carpet852/Kello/photos/IMG_8491.JPG

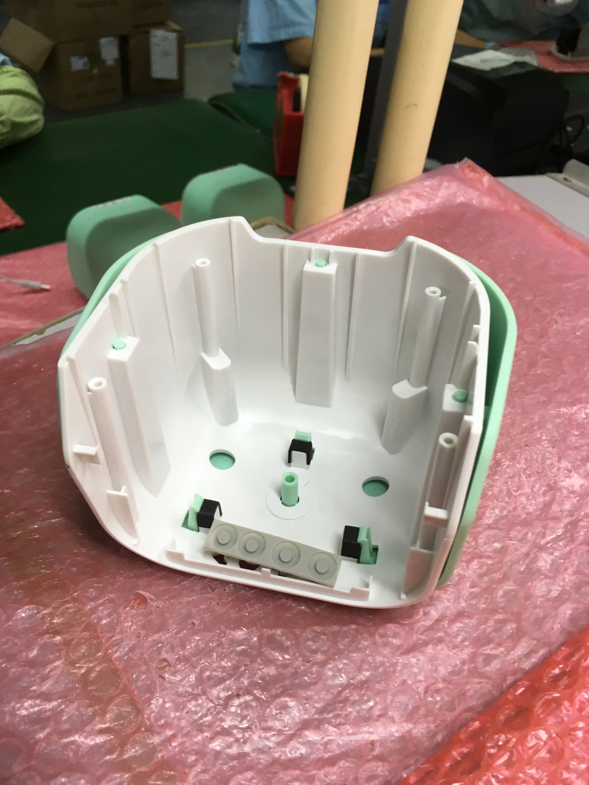
photos/IMG_8491.JPG
