carpet852/Kello/photos/IMG_8479.JPG

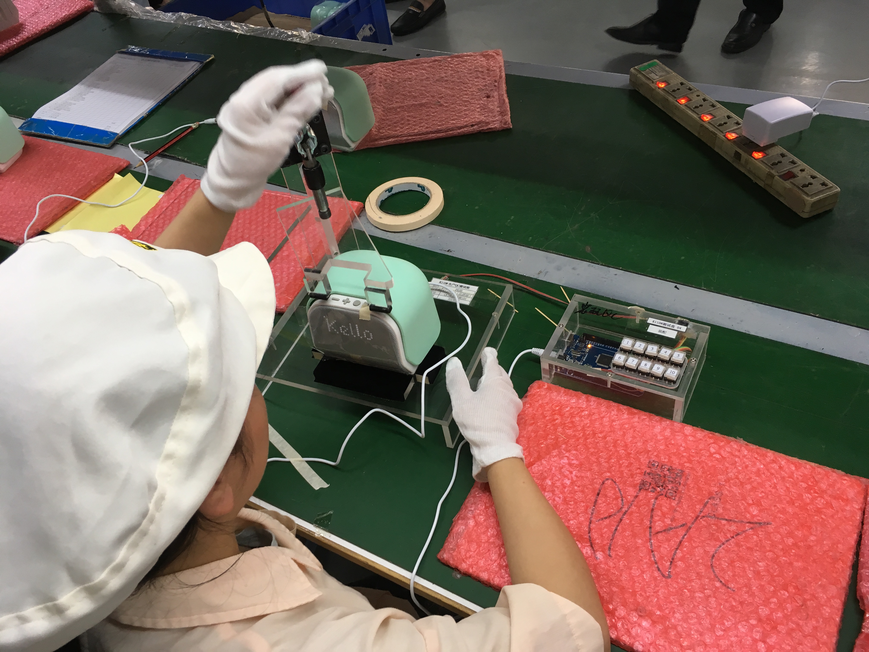
photos/IMG_8479.JPG
