carpet852/Kello/photos/13590448_10154298337113104_5472990157843542144_n.jpg

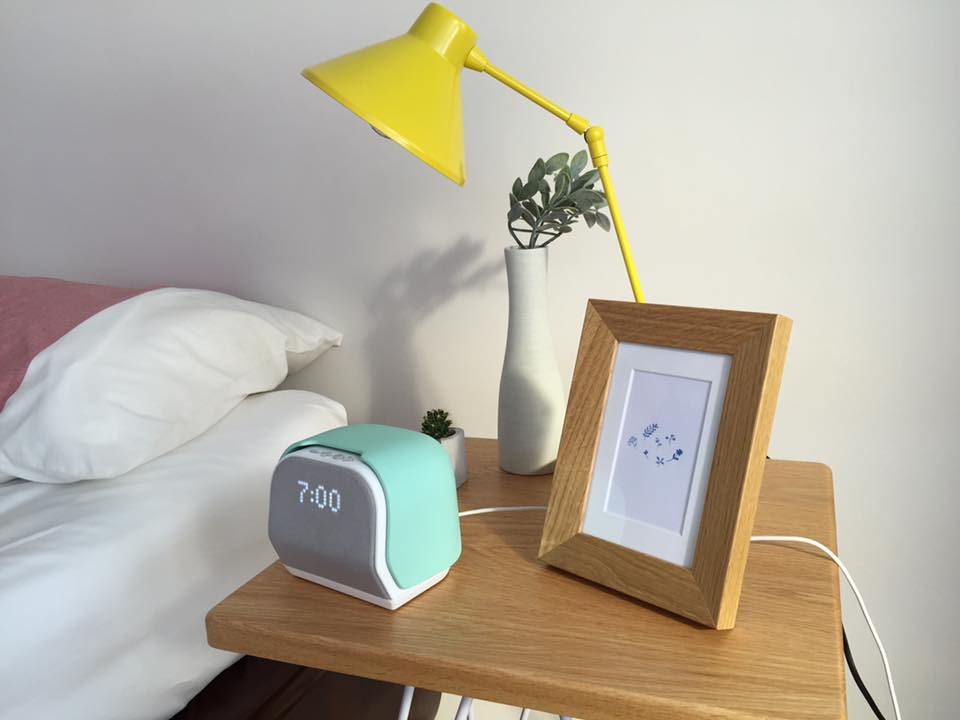
photos/13590448_10154298337113104_5472990157843542144_n.jpg
