carpet852/Kello/photos/CkaO5itWsAAXs07.jpg

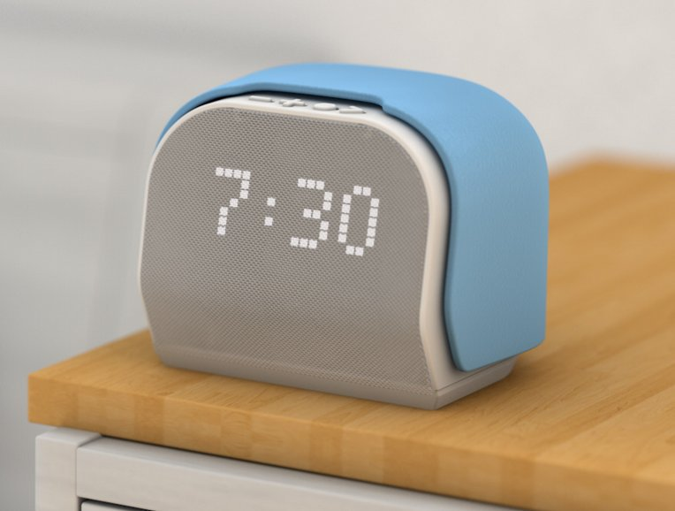
photos/CkaO5itWsAAXs07.jpg
