carpet852/Kello/photos/IMG_8485.JPG

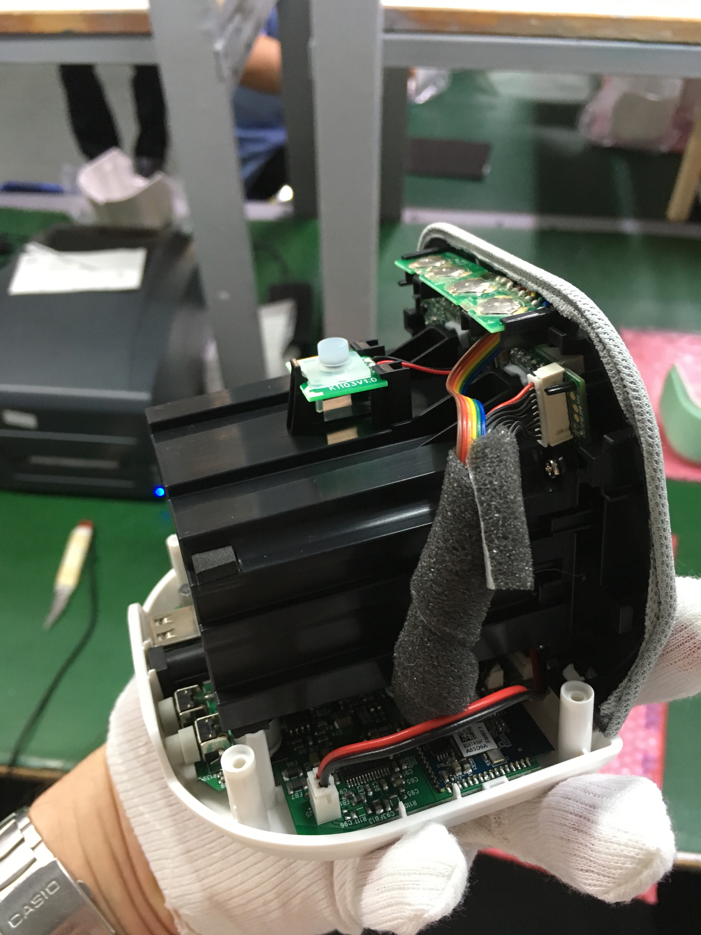
photos/IMG_8485.JPG
