carpet852/Kello/photos/IMG_8500.JPG

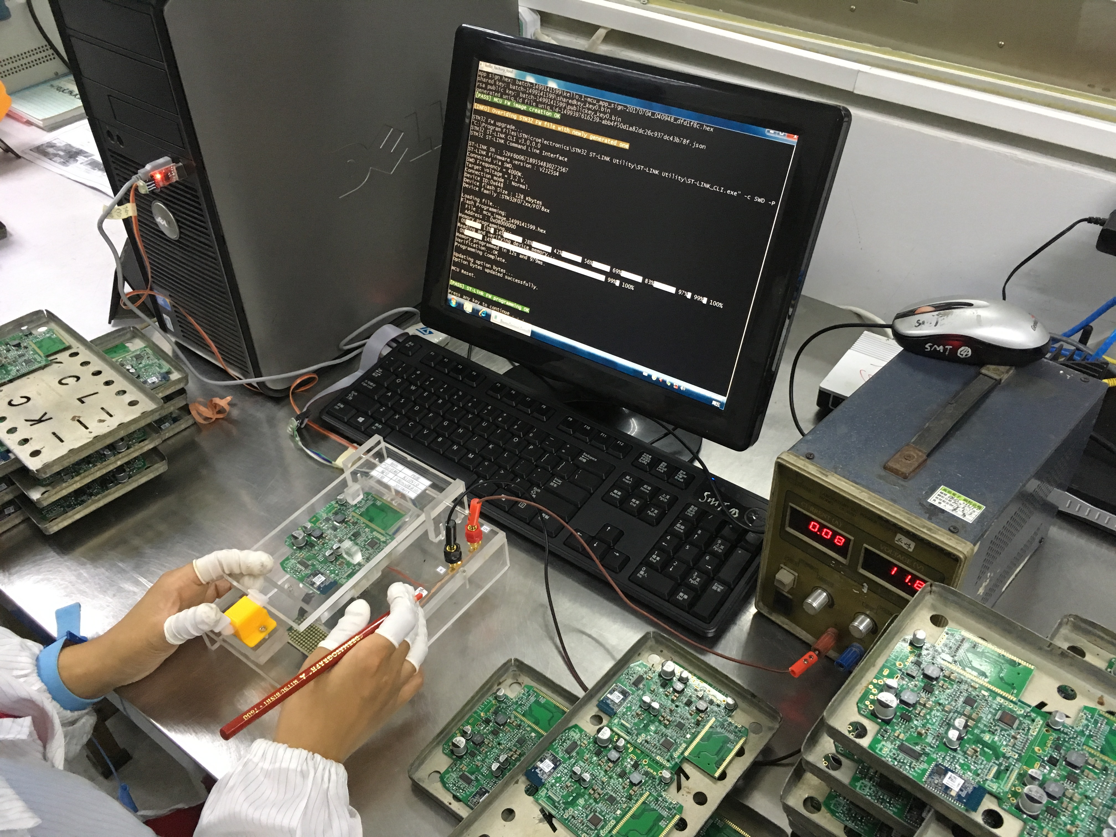
photos/IMG_8500.JPG
