carpet852/Kello/electronics/KELLO BUTTON V10 SCH.pdf

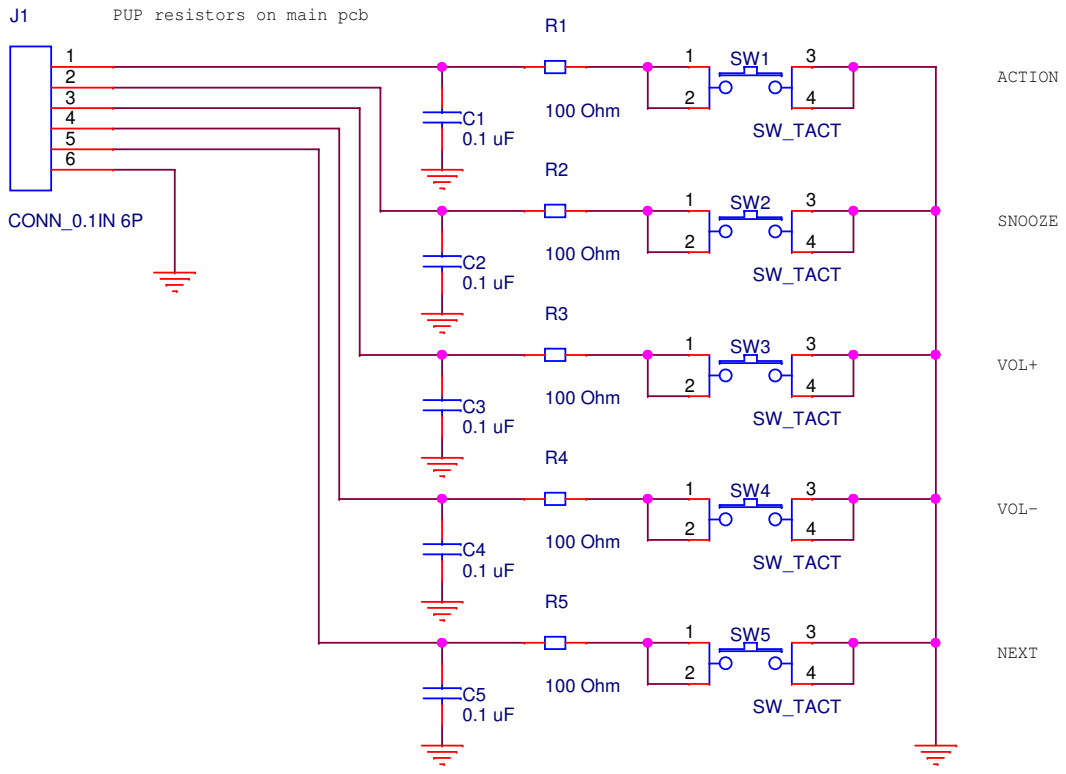
[picture p14: page 1]

PUP resistors on main pcb
