carpet852/Kello/electronics/KELLO_MAIN_V82_PROD_SCH.pdf

# KELLO block diagram

## WiFi

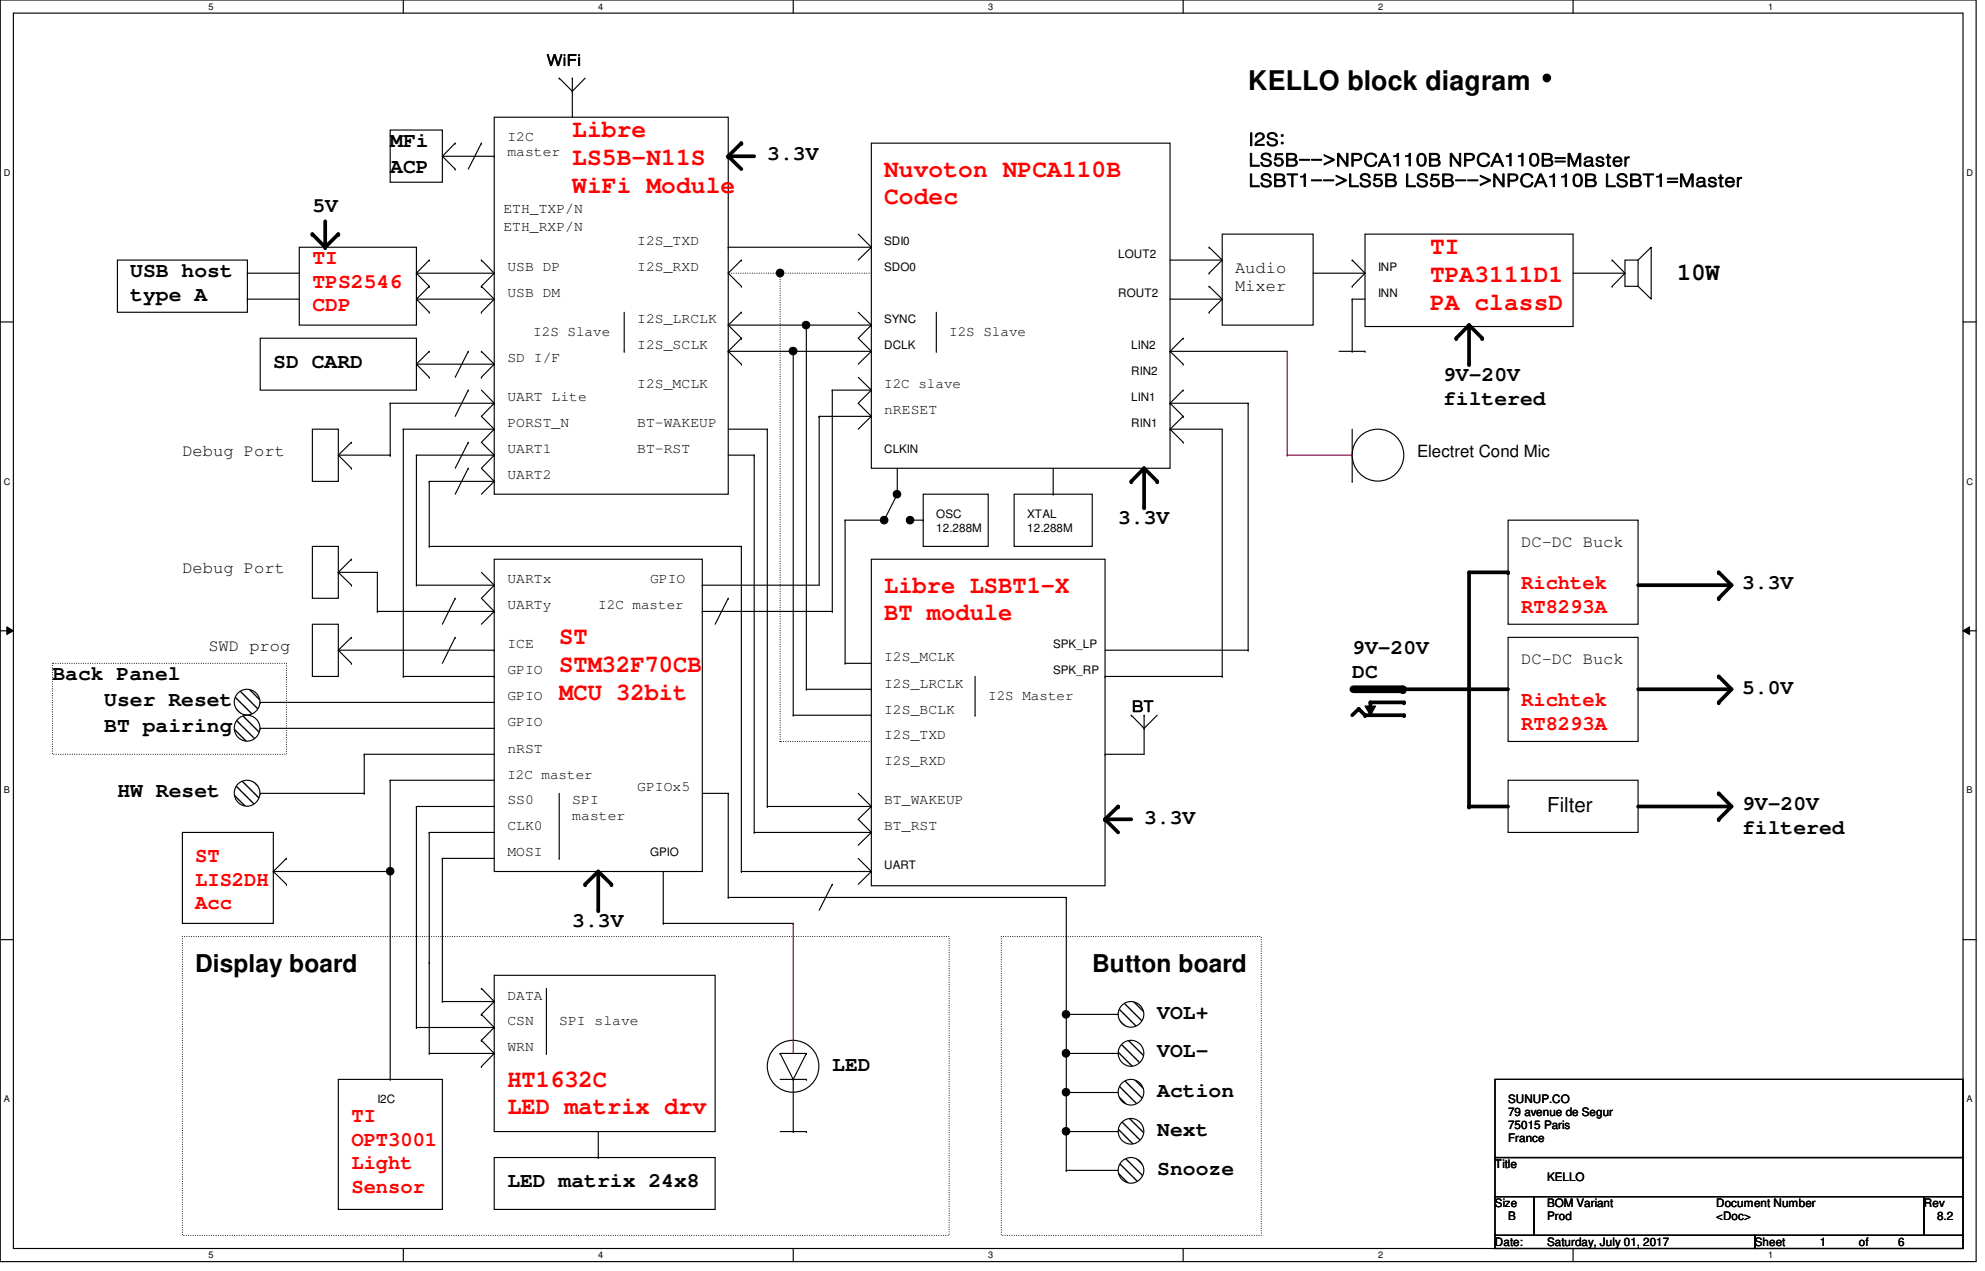
[picture p15: page 1]
I2S_RXD; UART Lite; ETH_TXP/N; SD CARD; Nuvoton NPCA110B Codec; I2S_LRCLK; USB DP; Debug Port; ETH_RXP/N; I2S_MCLK; Libre LS5B-N11S WiFi Module; USB DM; I2S_TXD; I2S_SCLK; ST STM32F70CB MCU 32bit; I2S: LS5B-->NPCA110B NPCA110B=Master LSBT1-->LS5B LS5B-->NPCA110B LSBT1=Master; UART2; USB host type A; VOL+; VOL-; Action; Next; I2C master; MFi ACP; Libre LSBT1-X BT module; I2S_BCLK; UART; DCLK; SDI0; SYNC; CLKIN; I2S Master; I2S Slave; BT-RST; BT-WAKEUP; BT_WAKEUP; BT_RST; I2C slave; UART1; UARTx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

Electret Cond Mic

DC-DC Buck

SUNUP.CO
79 avenue de Segur
75015 Paris
France

## Overvoltage 20.5V Reverse Pol. 1.3V

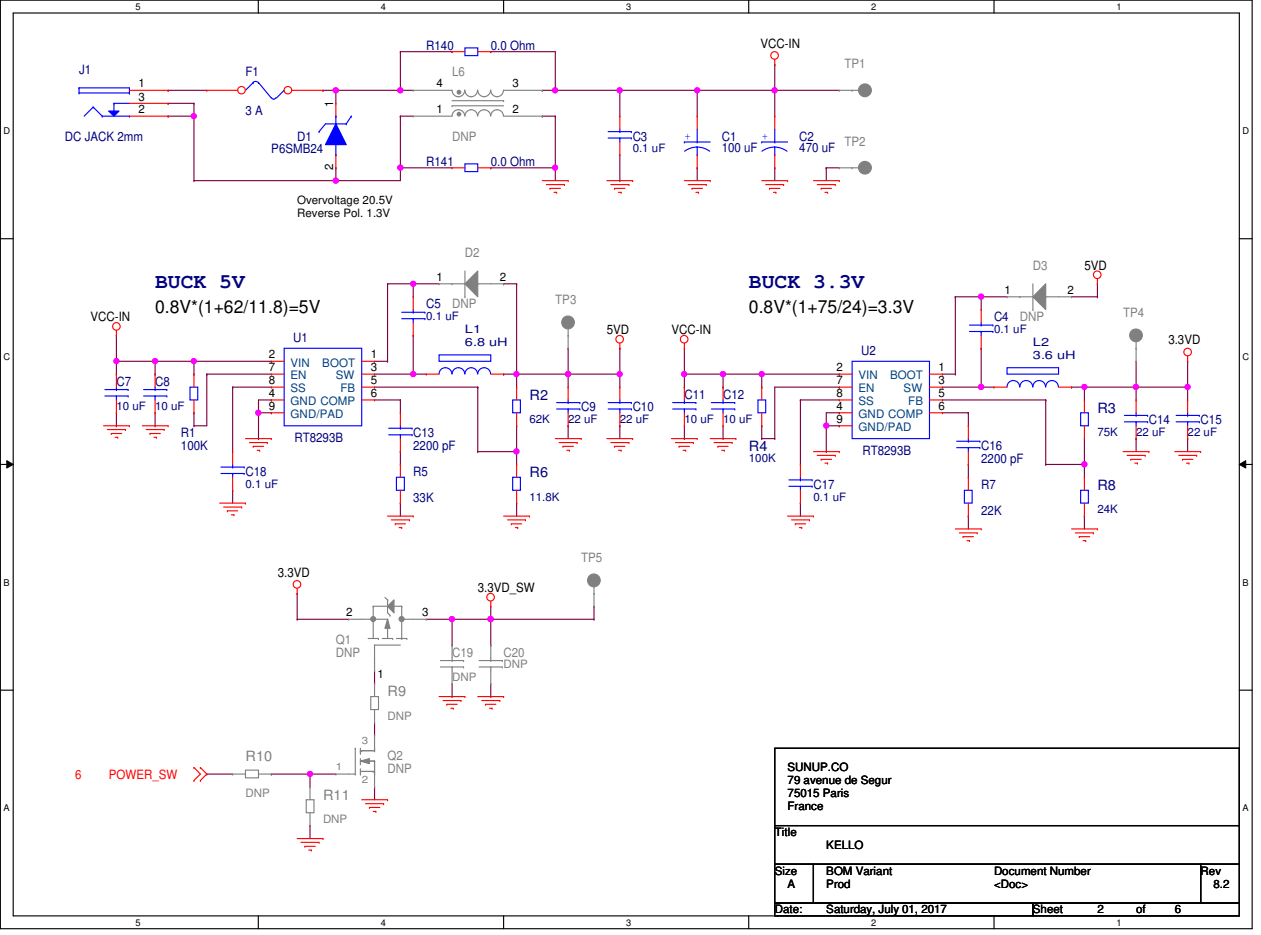
[picture p16: page 2]

## I2SDI_LSBT not supported in digital mode LSBT-A ADC method: unpop R14/R16/R18, pop R20

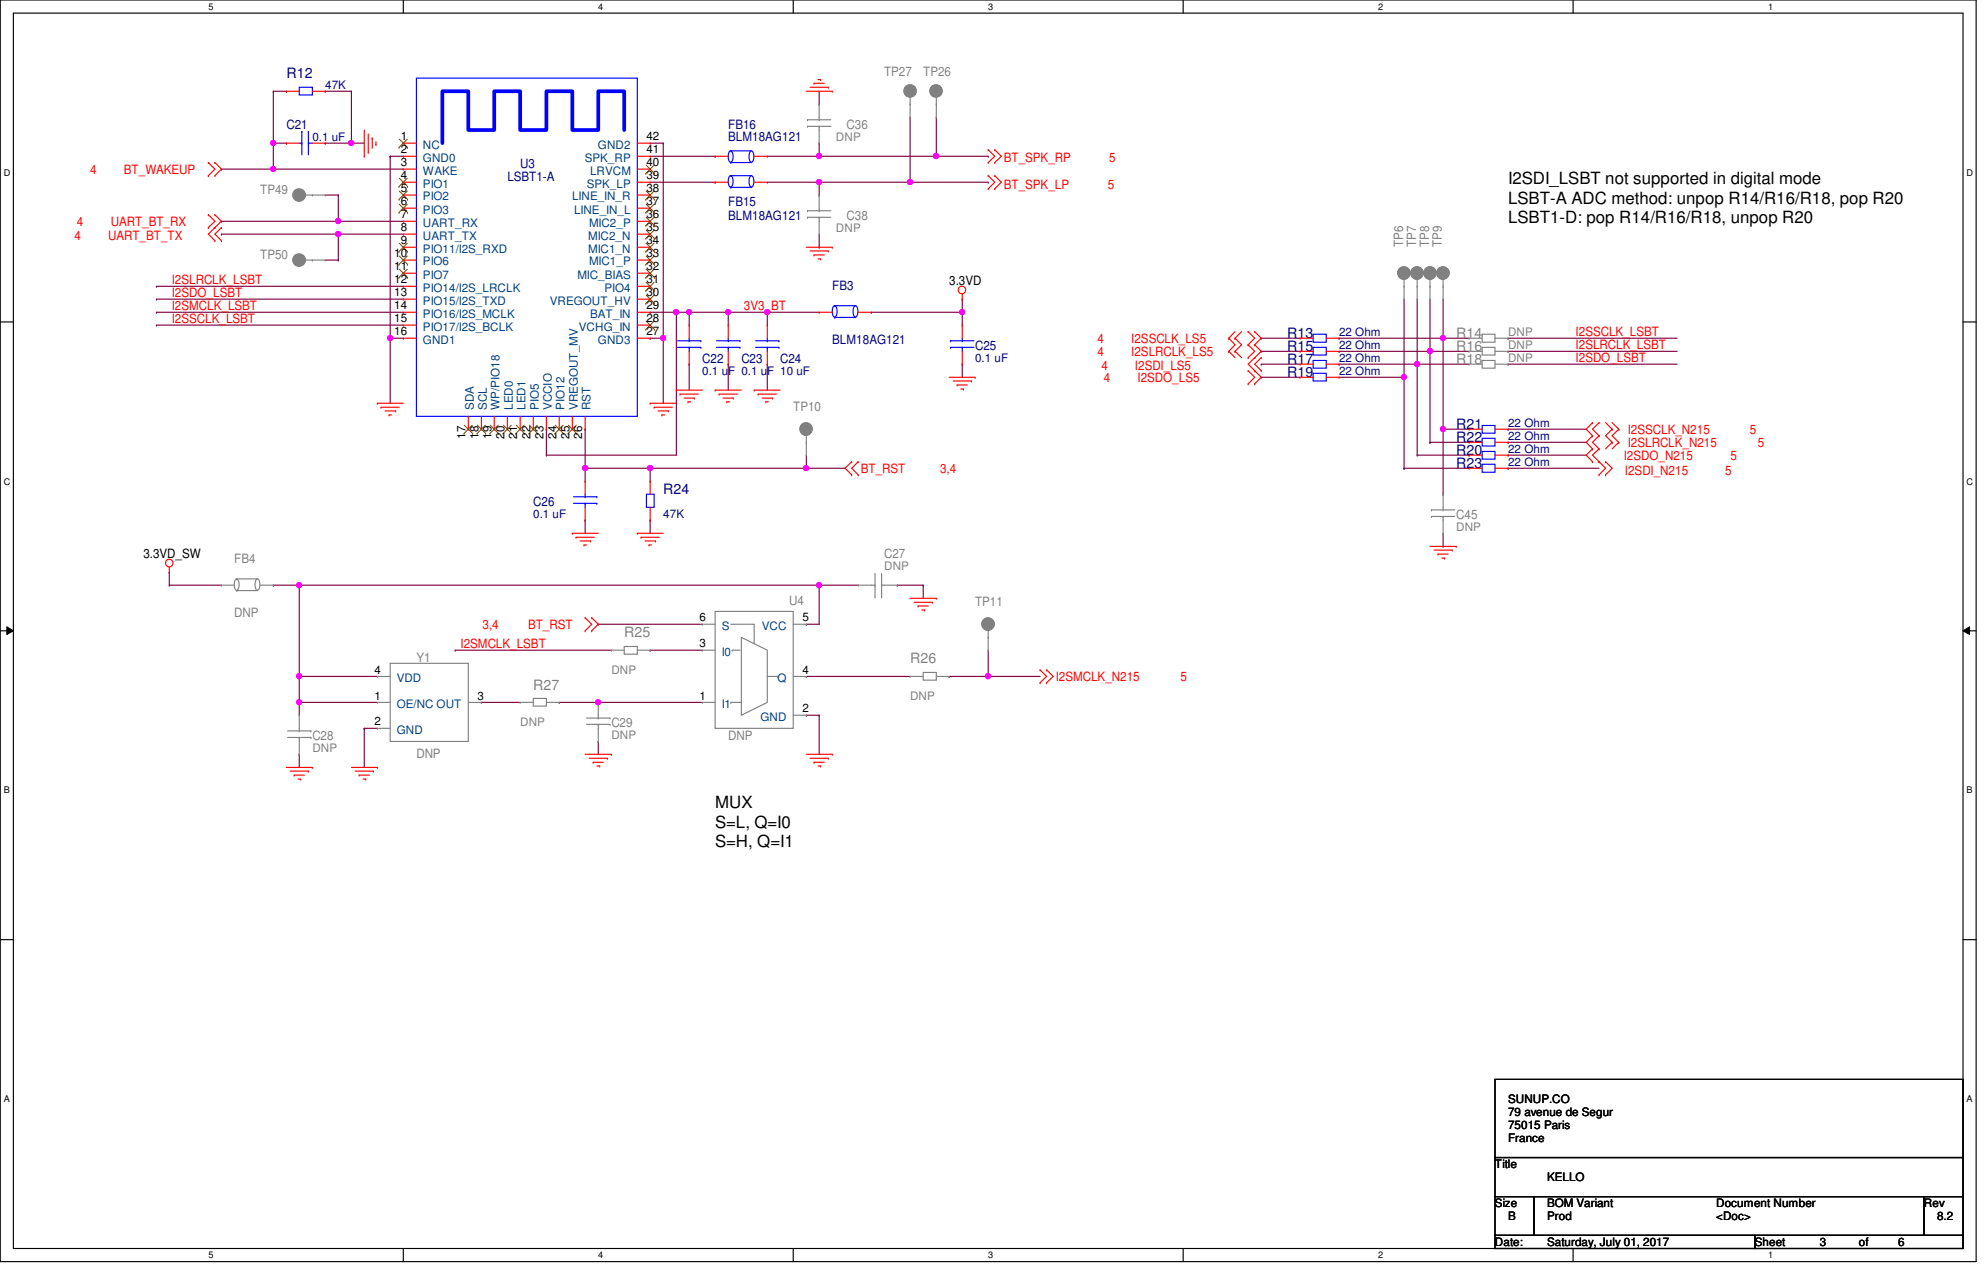
[picture p17: page 3]

## USB HOST

## cut PCB around LS5B antenna

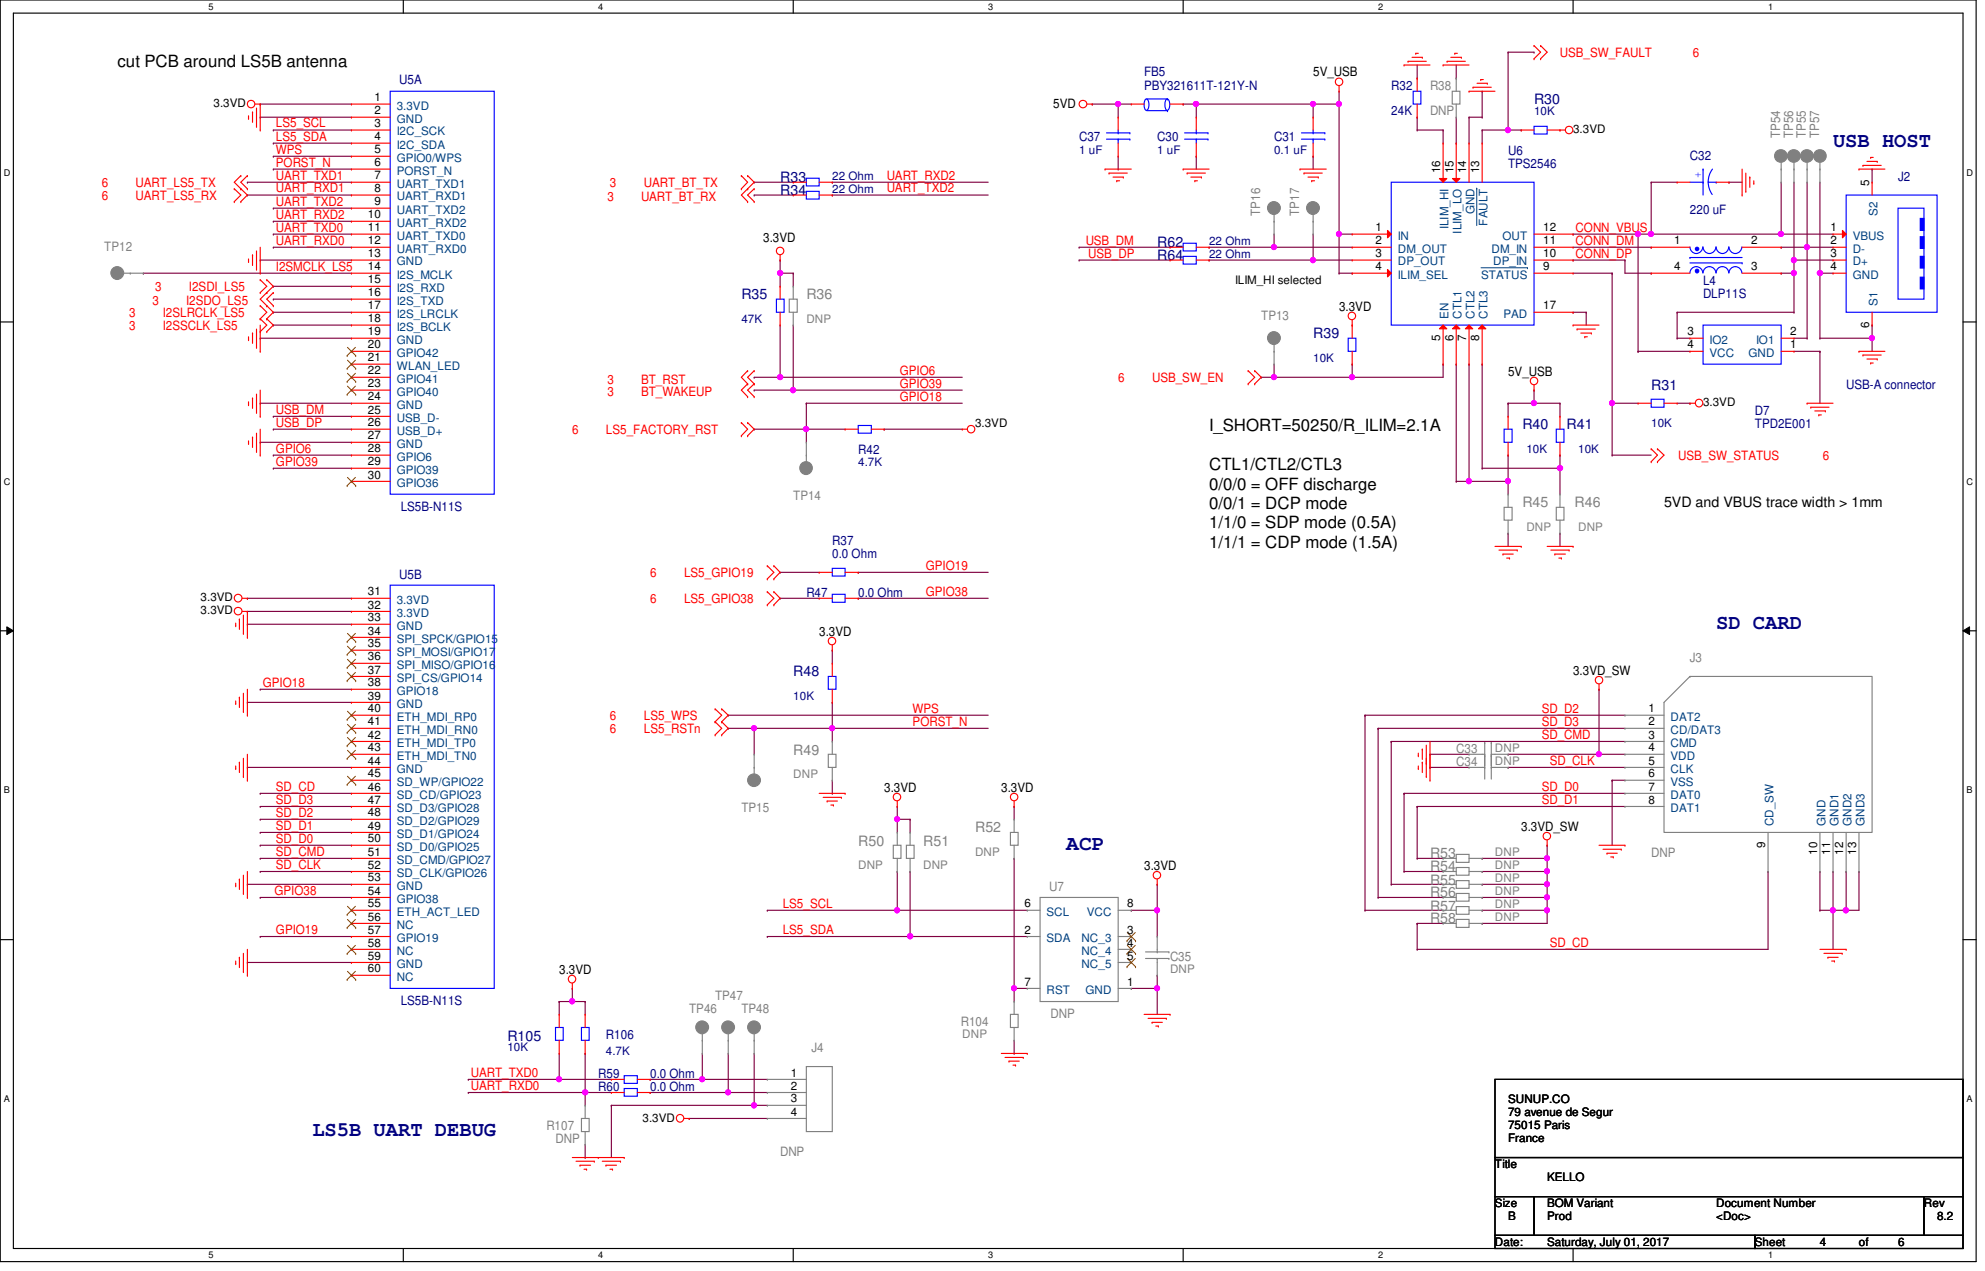
[picture p18: page 4]

5VD and VBUS trace width > 1mm

R68

R120

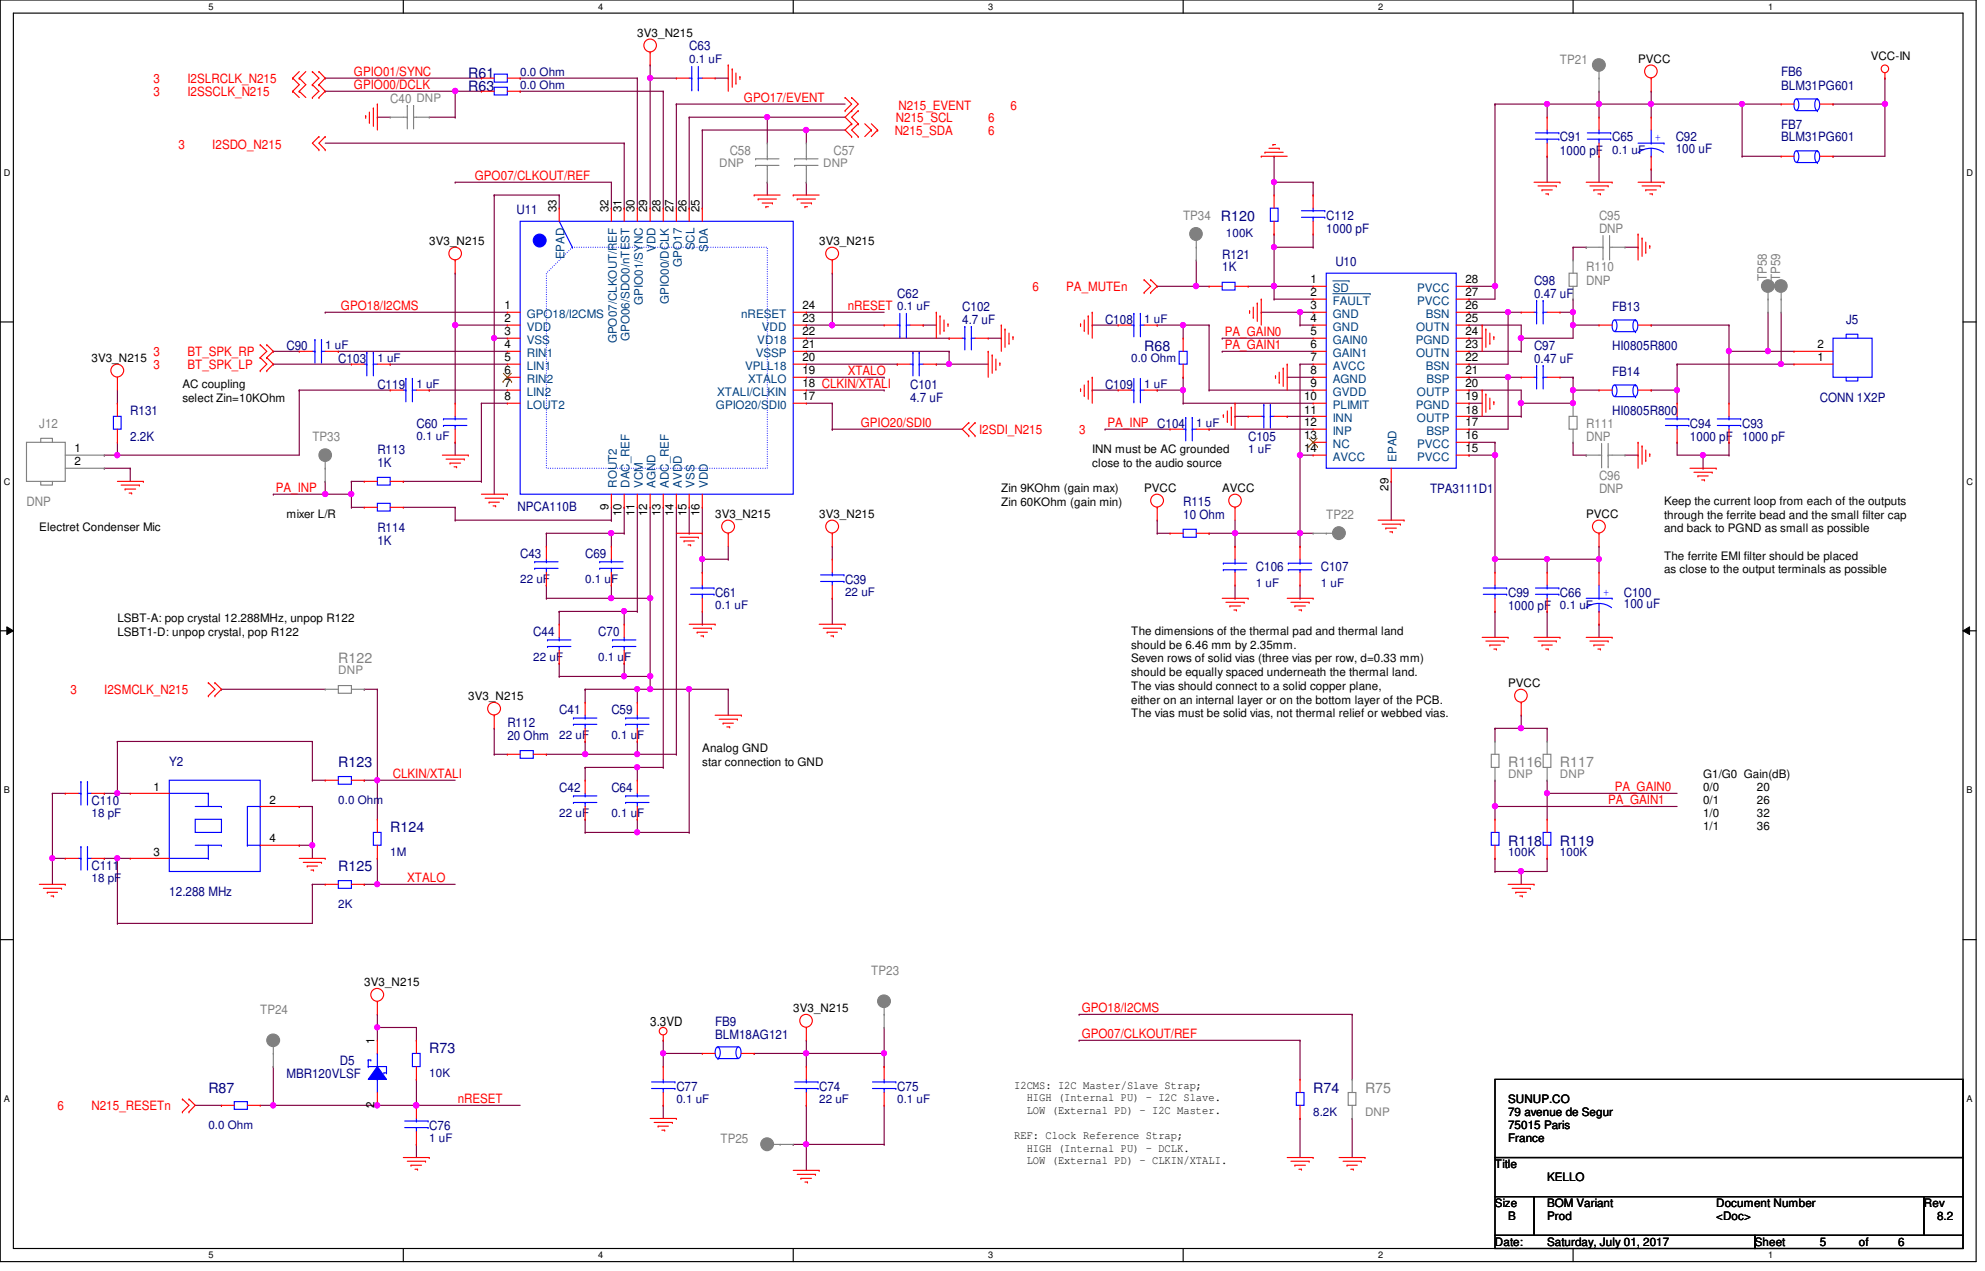
[picture p19: page 5]

INN must be AC grounded
close to the audio source

Keep the current loop from each of the outputs
through the ferrite bead and the small filter cap
and back to PGND as small as possible

The ferrite EMI filter should be placed
as close to the output terminals as possible

LSBT-A: pop crystal 12.288MHz, unpop R122
LSBT1-D: unpop crystal, pop R122

The dimensions of the thermal pad and thermal land
should be 6.46 mm by 2.35mm.
Seven rows of solid vias (three vias per row, d=0.33 mm)
should be equally spaced underneath the thermal land.
The vias should connect to a solid copper plane,
either on an internal layer or on the bottom layer of the PCB.
The vias must be solid vias, not thermal relief or webbed vias.

Analog GND
star connection to GND

I2CMS: I2C Master/Slave Strap;
HIGH (Internal PU) - I2C Slave.
LOW (External PD) - I2C Master.

REF: Clock Reference Strap;
HIGH (Internal PU) - DCLK.
LOW (External PD) - CLKIN/XTALI.

## BUTTON CONNECTOR

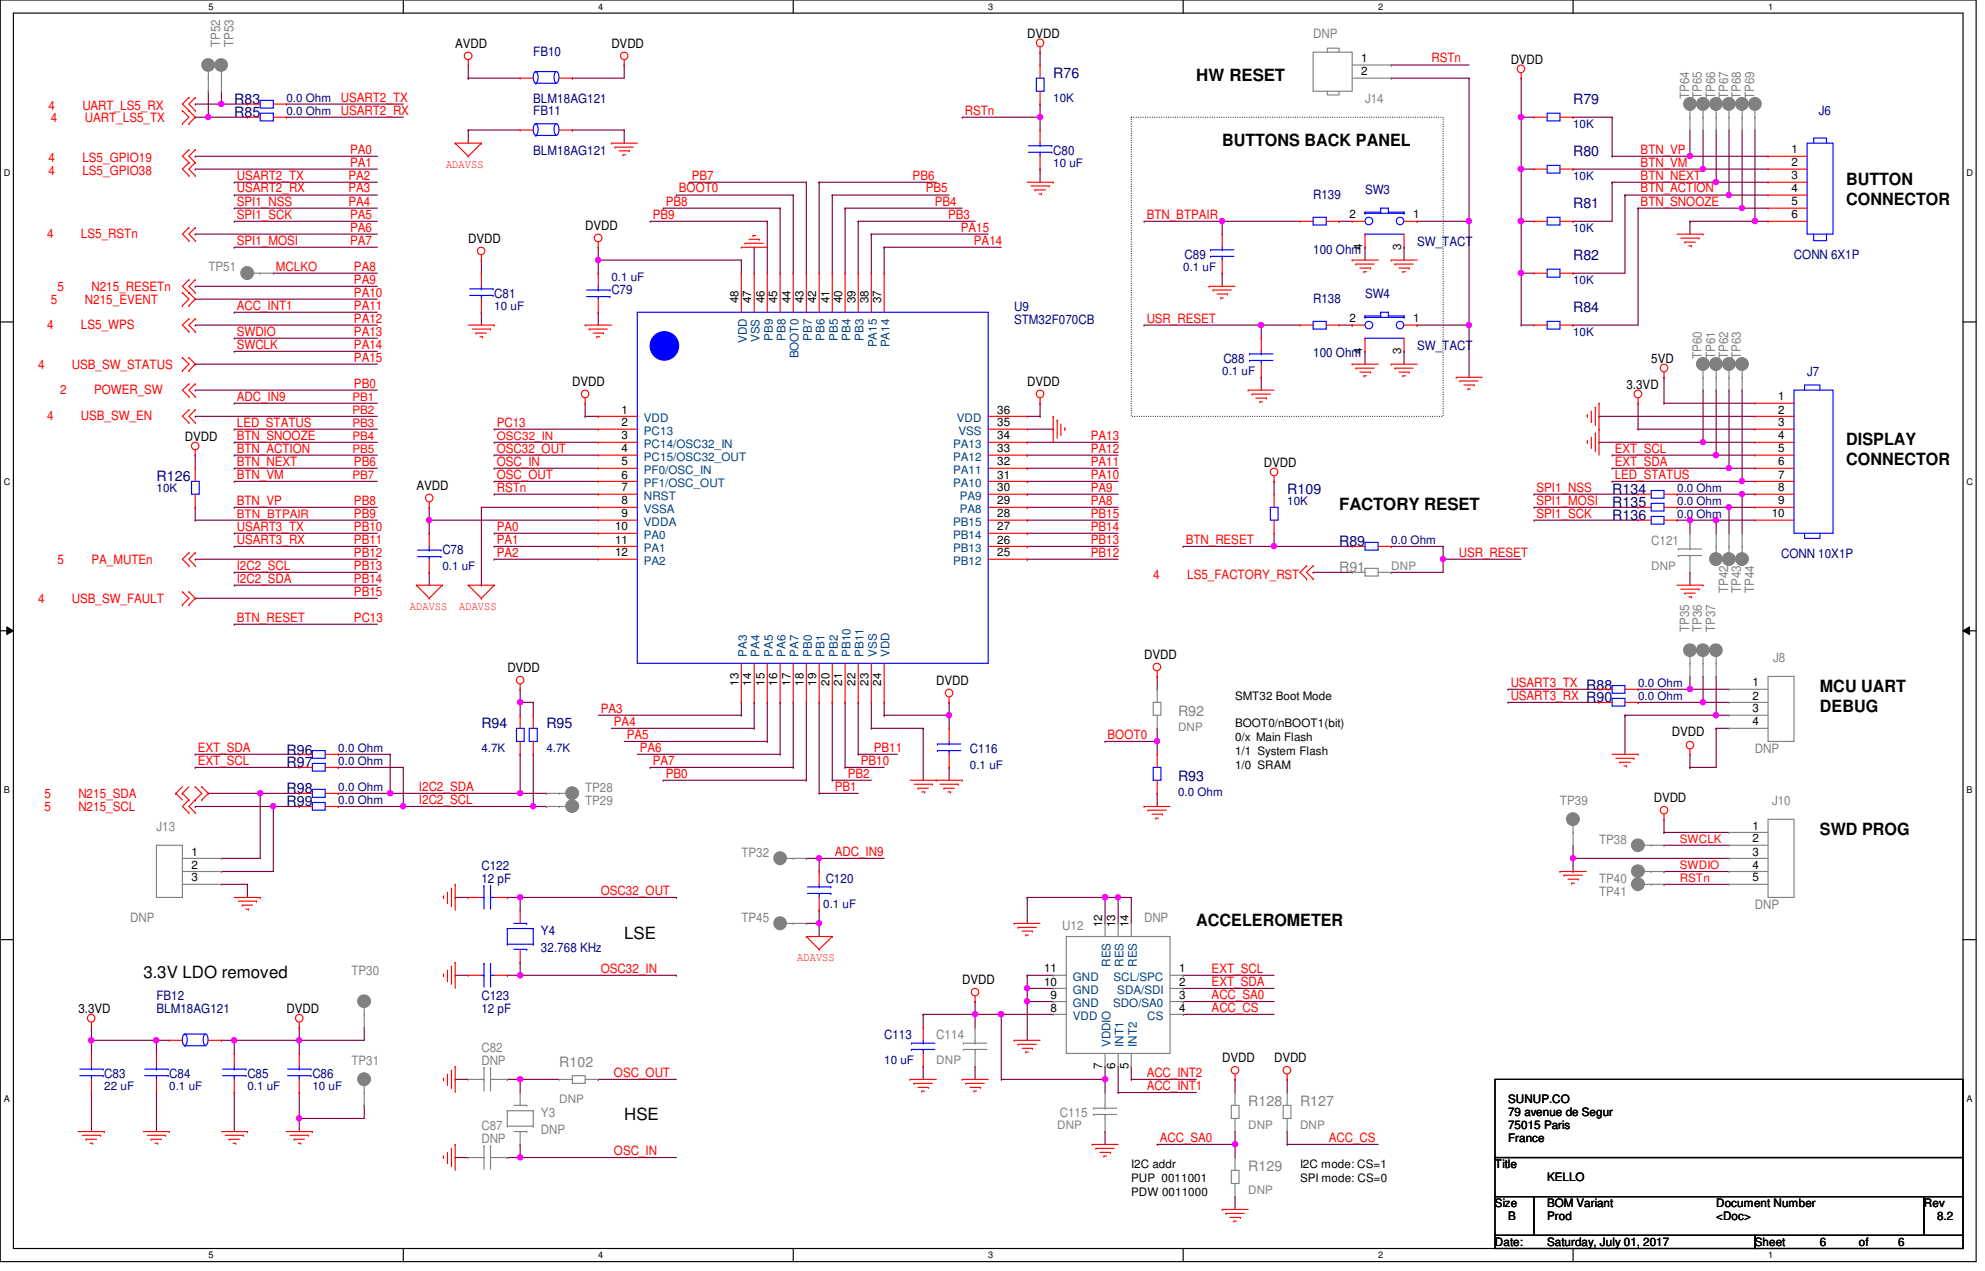
[picture p20: page 6]
