carpet852/Kello/electronics/KELLO_DISPLAY_V61_PROD_SCH.pdf

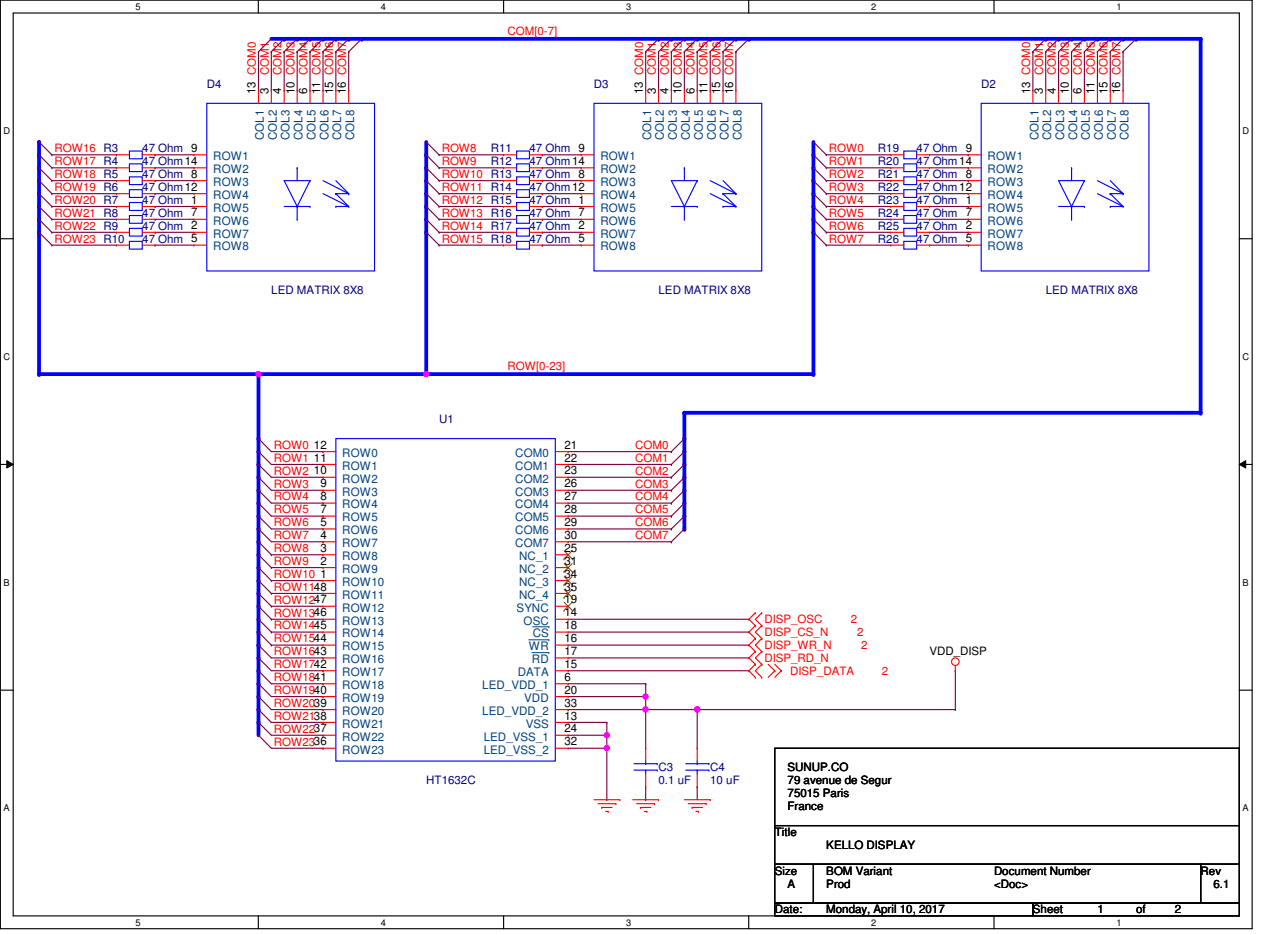
[picture p21: page 1]

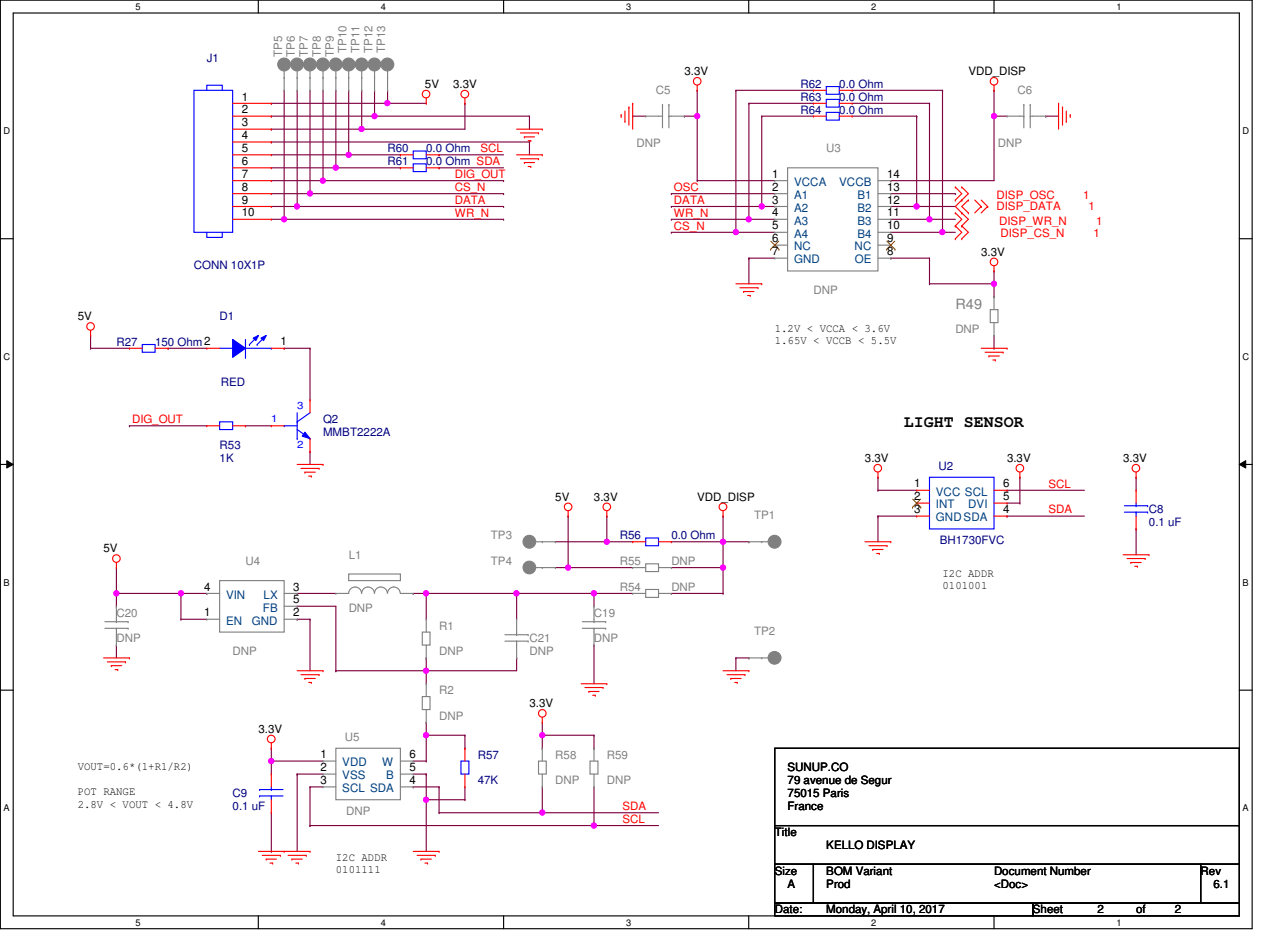
[picture p22: page 2]
