carpet852/Kello/photos/IMG_8483.JPG

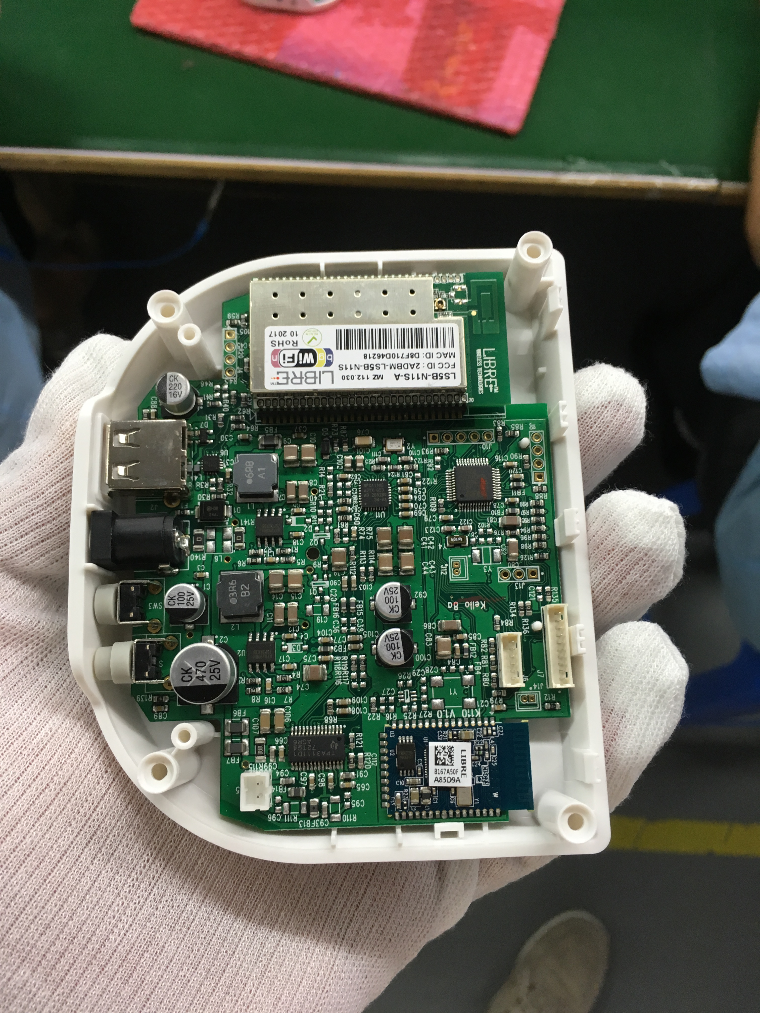
photos/IMG_8483.JPG
